porast1/suspension-telemetry/PCB_Design/Suspension_telemetry/lib_symbol/3dmodel/OLED-128x64-0.96.png

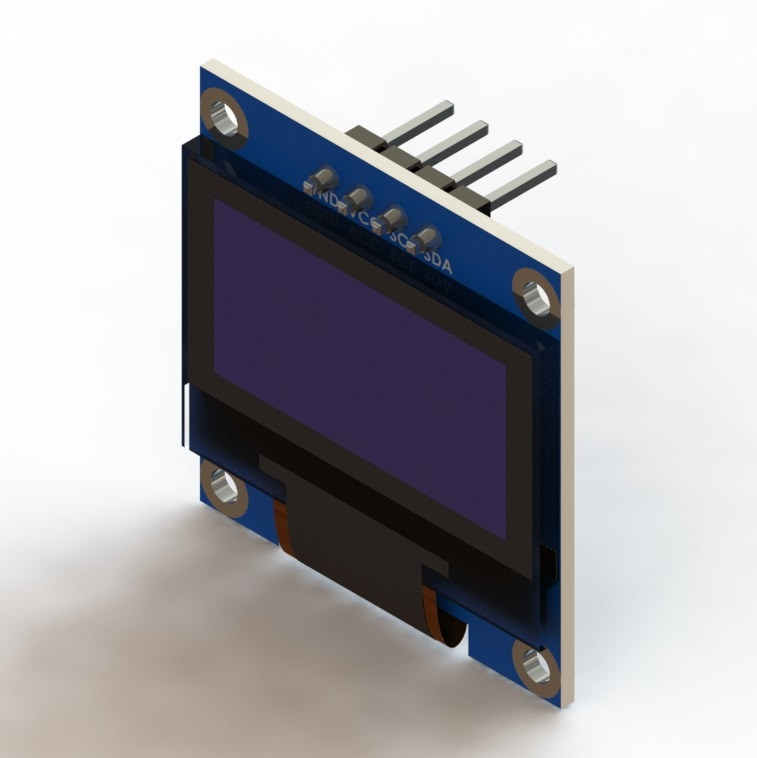
PCB_Design/Suspension_telemetry/lib_symbol/3dmodel/OLED-128x64-0.96.png
