porast1/suspension-telemetry/Enclosure/My_Designs/Enclosure-Main_body.step

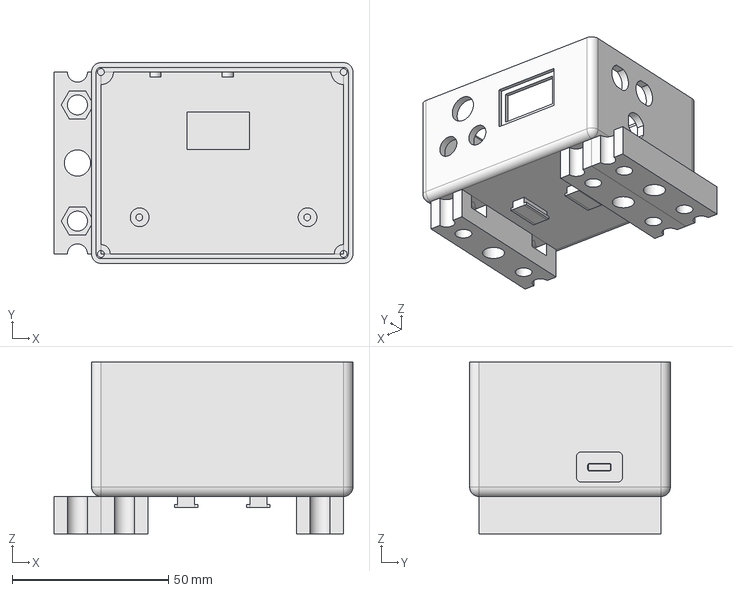
[picture p14: CAD file, 2024-03-28]
Enclosure/My_Designs/Enclosure-Main_body.step
95.6 x 64.2 x 55.0 mm
