porast1/suspension-telemetry/Enclosure/Imported/Enve M9 Carbon hanlebar DH.step

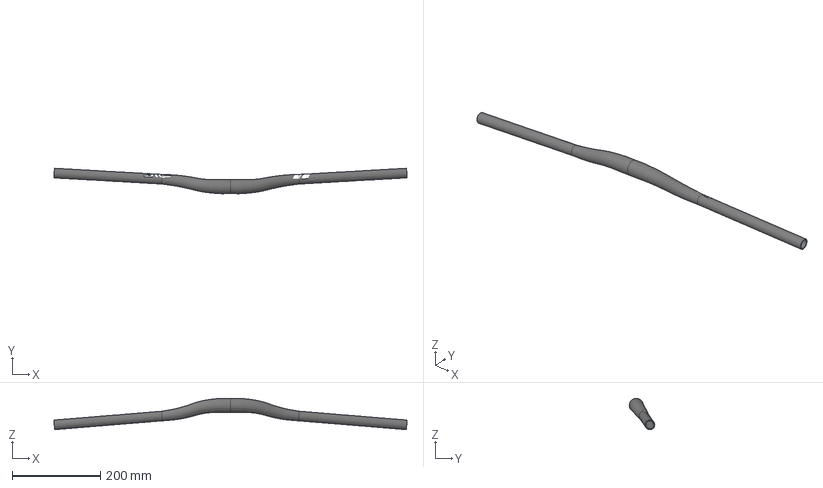
[picture p15: CAD file, 2023-11-22]
Enclosure/Imported/Enve M9 Carbon hanlebar DH.step
801.6 x 58.0 x 71.1 mm
