porast1/suspension-telemetry/Enclosure/My_Designs/mount_rear_frame_linkage-Body.step

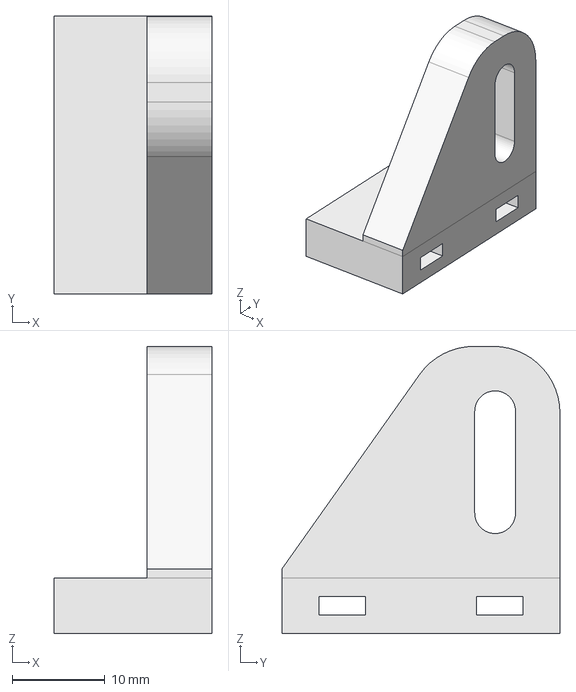
[picture p16: CAD file, 2024-03-28]
Enclosure/My_Designs/mount_rear_frame_linkage-Body.step
17.0 x 30.0 x 31.0 mm
