porast1/suspension-telemetry/PCB_Design/Suspension_telemetry/lib_symbol/3dmodel/momentary-button-switch-8mm-thread-2.snapshot.1/24V 8mm Momentary Switch.step

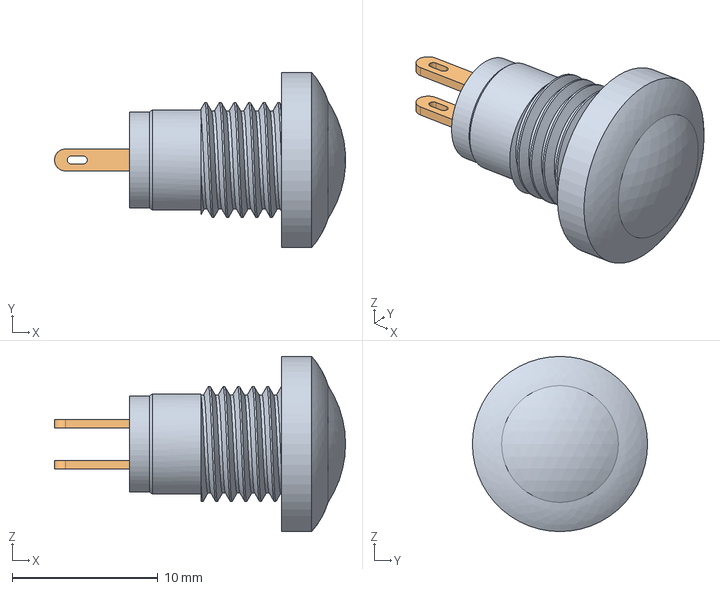
[picture p17: CAD file, 2023-11-22]
PCB_Design/Suspension_telemetry/lib_symbol/3dmodel/momentary-button-switch-8mm-thread-2.snapshot.1/24V 8mm Momentary Switch.step
19.9 x 12.0 x 12.0 mm
