porast1/suspension-telemetry/PCB_Design/Suspension_telemetry/lib_symbol/3dmodel/obudowa v3.3mf

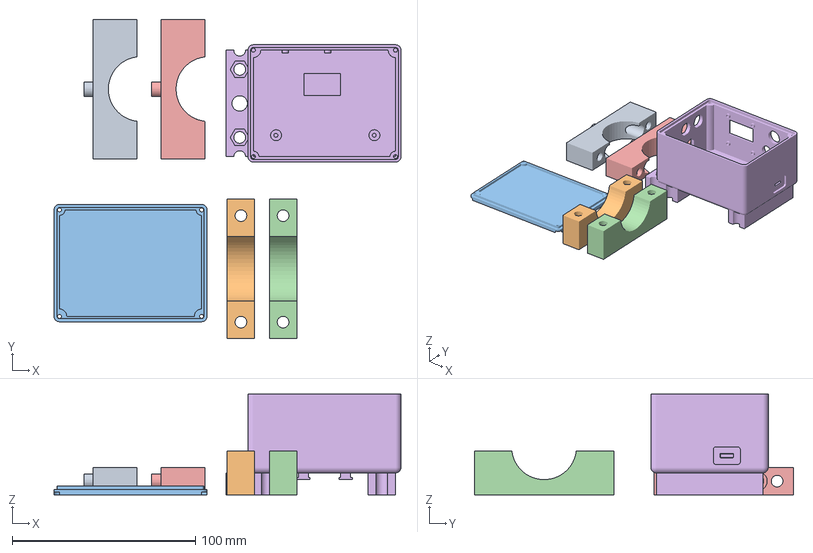
[picture p18: CAD file, 2023-12-28]
PCB_Design/Suspension_telemetry/lib_symbol/3dmodel/obudowa v3.3mf
189.6 x 174.4 x 55.0 mm
Mocowanie_obudowa_v2.stl x 2
ostatinie_mocowanie_v2.stl x 2
Pokrywa_v2.stl
obudowa v3.stl
