porast1/suspension-telemetry/PCB_Design/Suspension_telemetry/lib_symbol/LIB_112J-TDAR-R01/112J-TDAR-R01/3D/112J-TDAR-R01.stp

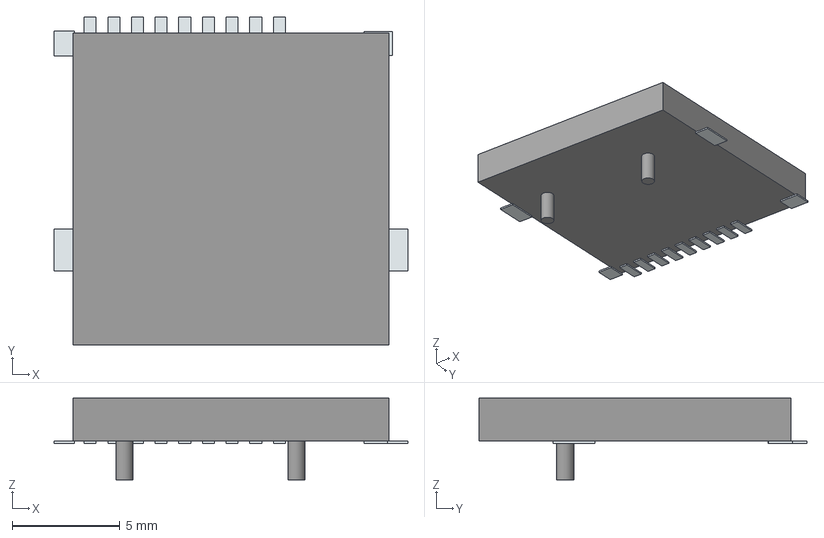
[picture p19: CAD file, 2023-10-05]
PCB_Design/Suspension_telemetry/lib_symbol/LIB_112J-TDAR-R01/112J-TDAR-R01/3D/112J-TDAR-R01.stp
16.5 x 15.2 x 3.80 mm
Pins
Lugs
