porast1/suspension-telemetry/PCB_Design/Suspension_telemetry/lib_symbol/LQH3NPZ100MJRL/3D/LQH3NPZ100MJRL.stp

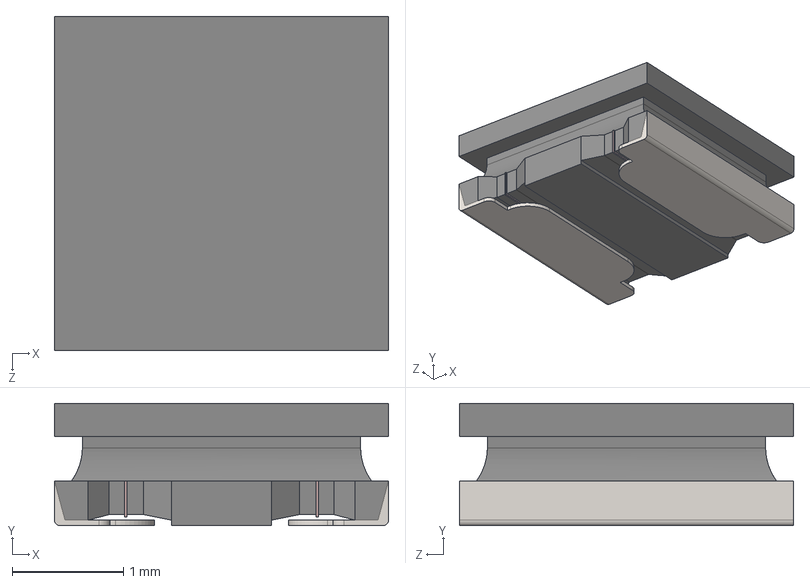
[picture p20: CAD file, 2023-11-22]
PCB_Design/Suspension_telemetry/lib_symbol/LQH3NPZ100MJRL/3D/LQH3NPZ100MJRL.stp
3.00 x 1.10 x 3.00 mm
