porast1/suspension-telemetry/PCB_Design/Suspension_telemetry/lib_symbol/MUSBRM1C1M0/3D/MUSBRM1C1M0.stp

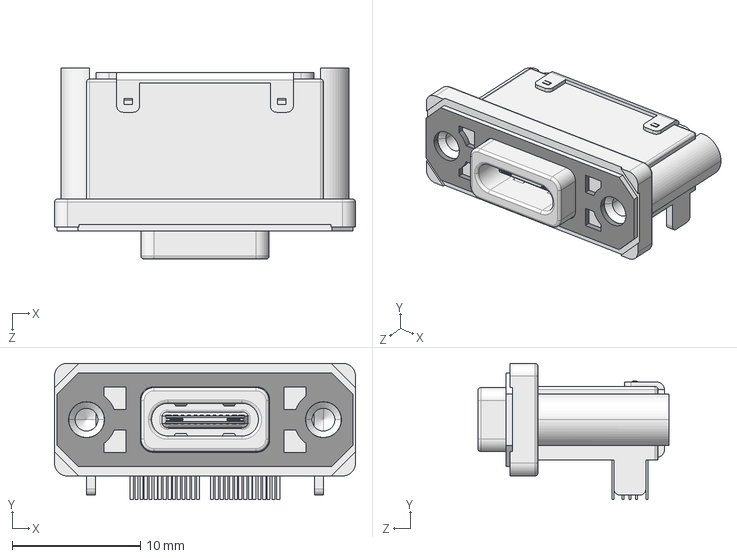
[picture p21: CAD file, 2023-11-22]
PCB_Design/Suspension_telemetry/lib_symbol/MUSBRM1C1M0/3D/MUSBRM1C1M0.stp
23.5 x 10.7 x 15.0 mm
