porast1/suspension-telemetry/PCB_Design/Suspension_telemetry/lib_symbol/zips/LIB_ABS07-32.768KHZ-9-T/ABS07-32.768KHZ-9-T/3D/ABS07-32.768KHZ-9-T.stp

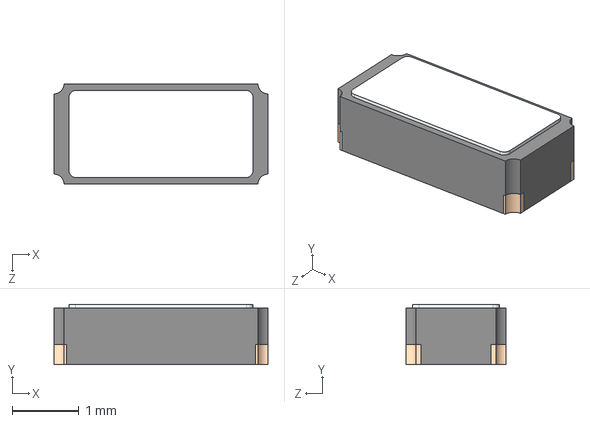
[picture p22: CAD file, 2023-10-05]
PCB_Design/Suspension_telemetry/lib_symbol/zips/LIB_ABS07-32.768KHZ-9-T/ABS07-32.768KHZ-9-T/3D/ABS07-32.768KHZ-9-T.stp
3.20 x 0.9 x 1.50 mm
