porast1/suspension-telemetry/PCB_Design/Suspension_telemetry/lib_symbol/zips/LIB_DR73-6R8-R/DR73-6R8-R/3D/DR73-6R8-R.stp

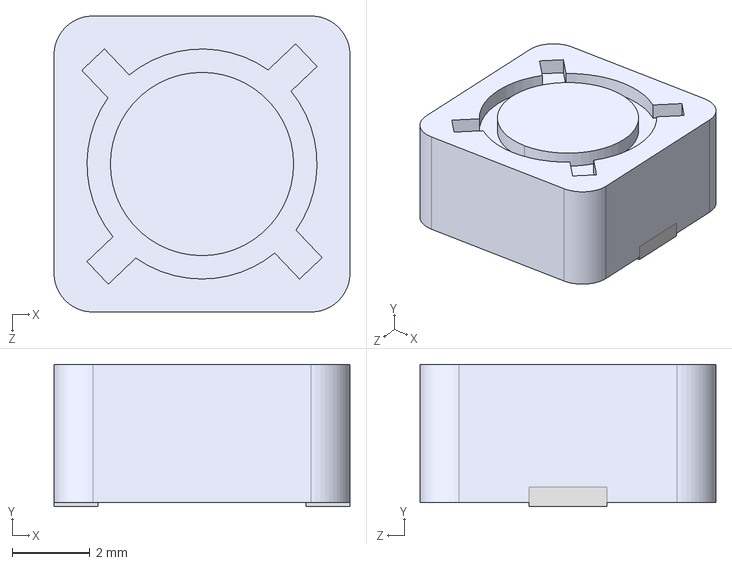
[picture p23: CAD file, 2023-10-05]
PCB_Design/Suspension_telemetry/lib_symbol/zips/LIB_DR73-6R8-R/DR73-6R8-R/3D/DR73-6R8-R.stp
7.60 x 3.65 x 7.60 mm
