porast1/suspension-telemetry/PCB_Design/Suspension_telemetry/lib_symbol/zips/LIB_HBHR-B2-10-VG-SMT/HBHR-B2-10-VG-SMT/3D/HBHR-B2-10-VG-SMT.stp

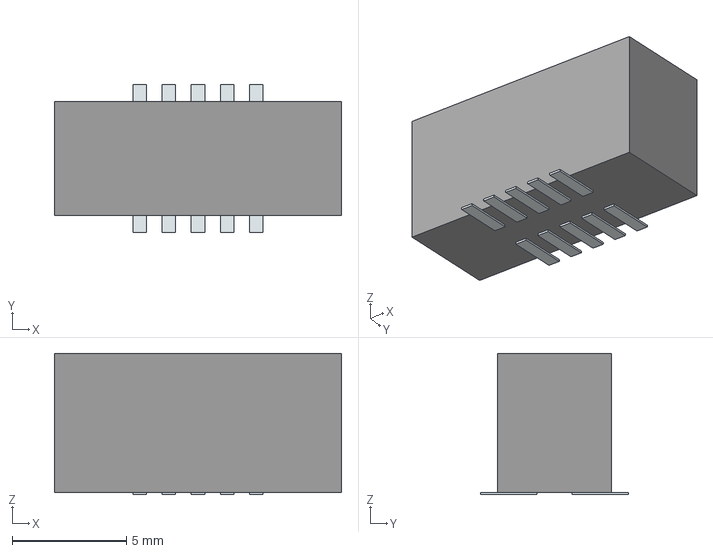
[picture p24: CAD file, 2023-10-05]
PCB_Design/Suspension_telemetry/lib_symbol/zips/LIB_HBHR-B2-10-VG-SMT/HBHR-B2-10-VG-SMT/3D/HBHR-B2-10-VG-SMT.stp
12.6 x 6.45 x 6.18 mm
Pins
