porast1/suspension-telemetry/PCB_Design/Suspension_telemetry/lib_symbol/zips/LIB_SI4435DY/SI4435DY/3D/SI4435DY.stp

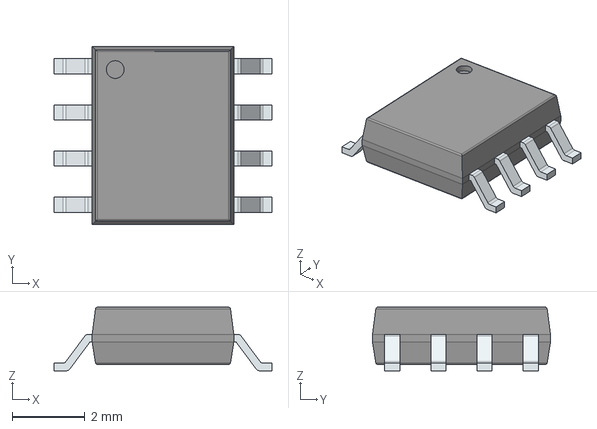
[picture p25: CAD file, 2023-10-05]
PCB_Design/Suspension_telemetry/lib_symbol/zips/LIB_SI4435DY/SI4435DY/3D/SI4435DY.stp
6.00 x 4.90 x 1.75 mm
PinsArrayLR
