porast1/suspension-telemetry/PCB_Design/Suspension_telemetry/lib_symbol/zips/LIB_USB4500-03-0-A/USB4500-03-0-A/3D/USB4500-03-0-A.stp

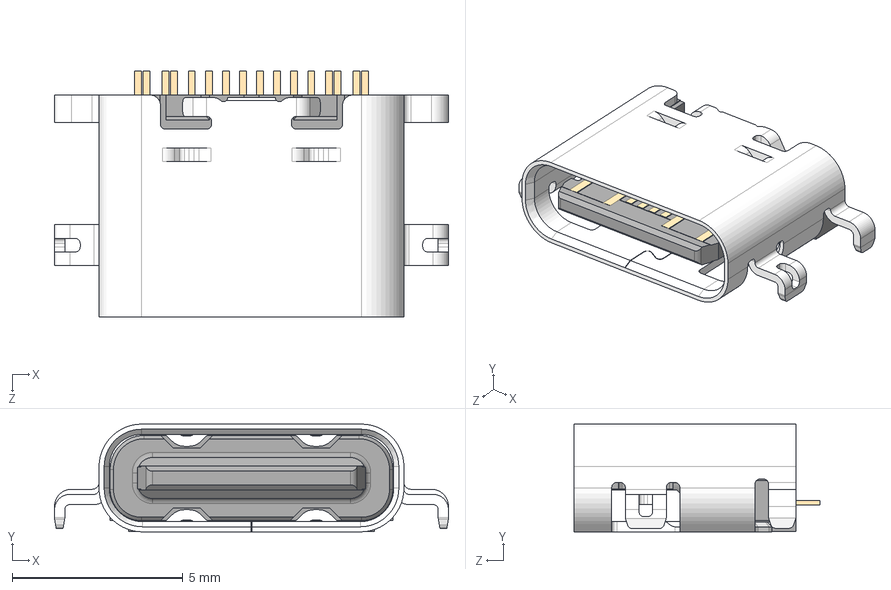
[picture p26: CAD file, 2023-10-05]
PCB_Design/Suspension_telemetry/lib_symbol/zips/LIB_USB4500-03-0-A/USB4500-03-0-A/3D/USB4500-03-0-A.stp
11.6 x 3.16 x 7.20 mm
housing mid 0.80
shell without spring
