porast1/suspension-telemetry/PCB_Design/Suspension_telemetry/travel_pressure_pcb/travel_pressure_pcb.step

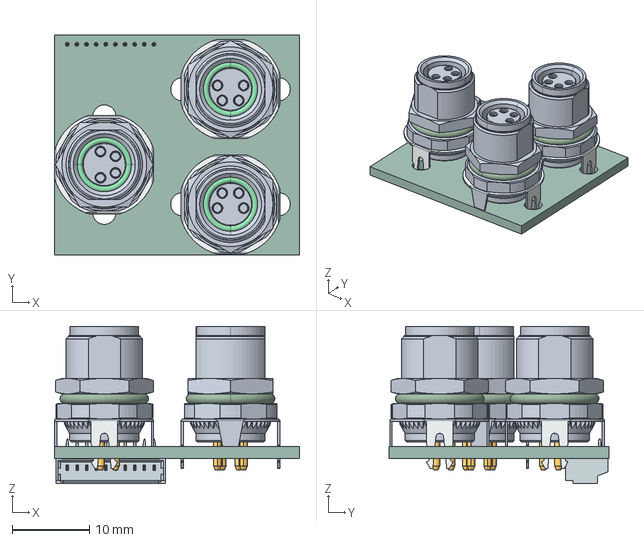
[picture p27: CAD file, 2023-11-22]
PCB_Design/Suspension_telemetry/travel_pressure_pcb/travel_pressure_pcb.step
31.8 x 28.6 x 20.4 mm
travel_pressure_pcb PCB
