porast1/suspension-telemetry/Enclosure/My_Designs/mount_bottom_fork.step

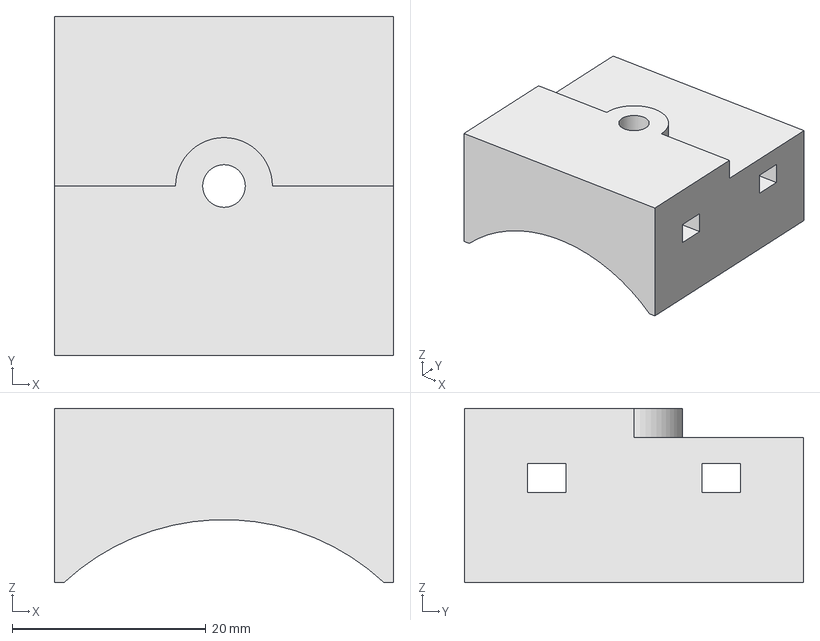
[picture p28: CAD file, 2024-03-28]
Enclosure/My_Designs/mount_bottom_fork.step
35.0 x 35.0 x 18.0 mm
