porast1/suspension-telemetry/Enclosure/My_Designs/Battery_mount.step

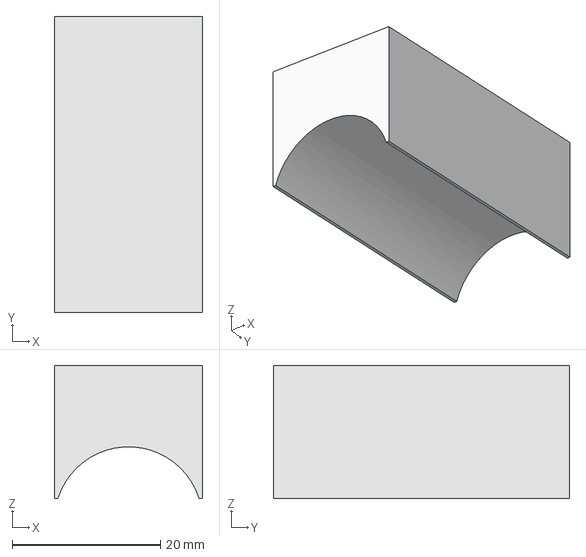
[picture p29: CAD file, 2024-03-28]
Enclosure/My_Designs/Battery_mount.step
20.0 x 40.0 x 18.0 mm
