porast1/suspension-telemetry/PCB_Design/Suspension_telemetry/lib_symbol/3dmodel/Monochrome 0.91’’ 128x32 I2C OLED Display DFR0647 (DFROBOT).STEP

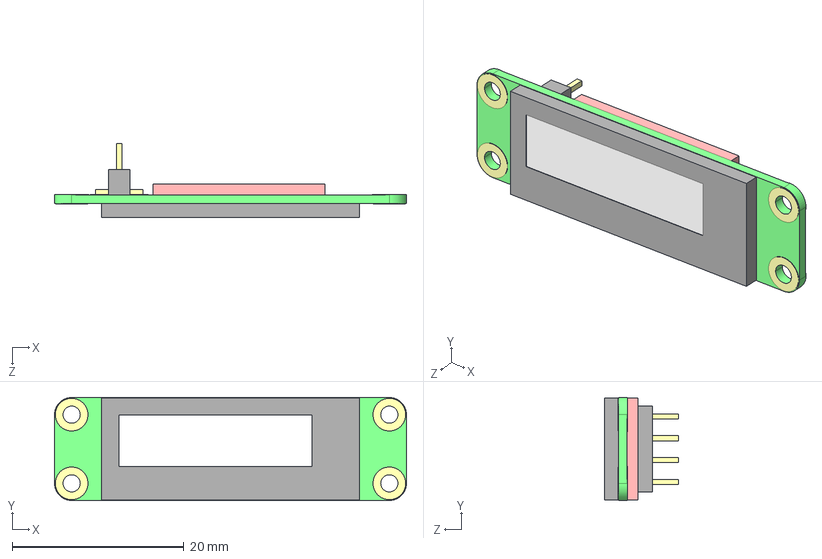
[picture p30: CAD file, 2023-11-22]
PCB_Design/Suspension_telemetry/lib_symbol/3dmodel/Monochrome 0.91’’ 128x32 I2C OLED Display DFR0647 (DFROBOT).STEP
41.0 x 12.0 x 8.60 mm
