porast1/suspension-telemetry/Enclosure/My_Designs/Enclosure-Handlebar_Mount_2.step

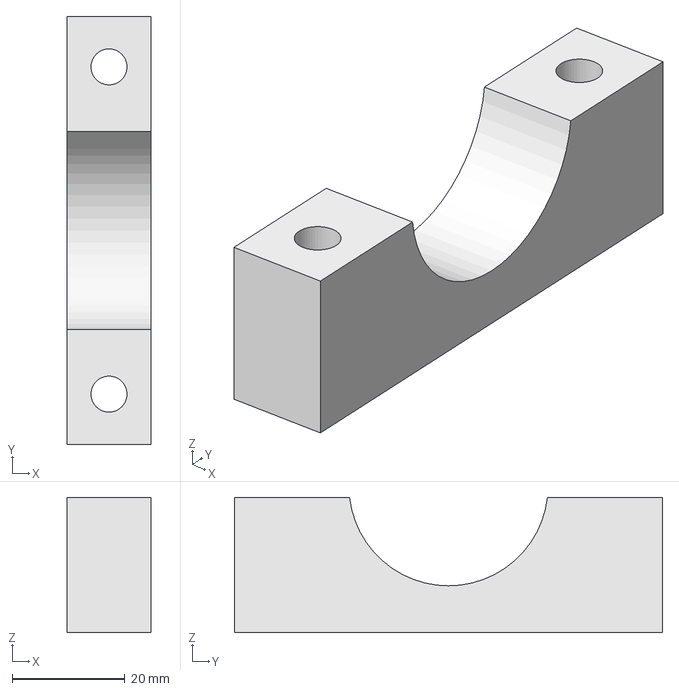
[picture p31: CAD file, 2024-03-28]
Enclosure/My_Designs/Enclosure-Handlebar_Mount_2.step
15.0 x 76.2 x 24.0 mm
