porast1/suspension-telemetry/PCB_Design/Suspension_telemetry/lib_symbol/3dmodel/USB3505-30-A--3DModel-STEP-56544.STEP

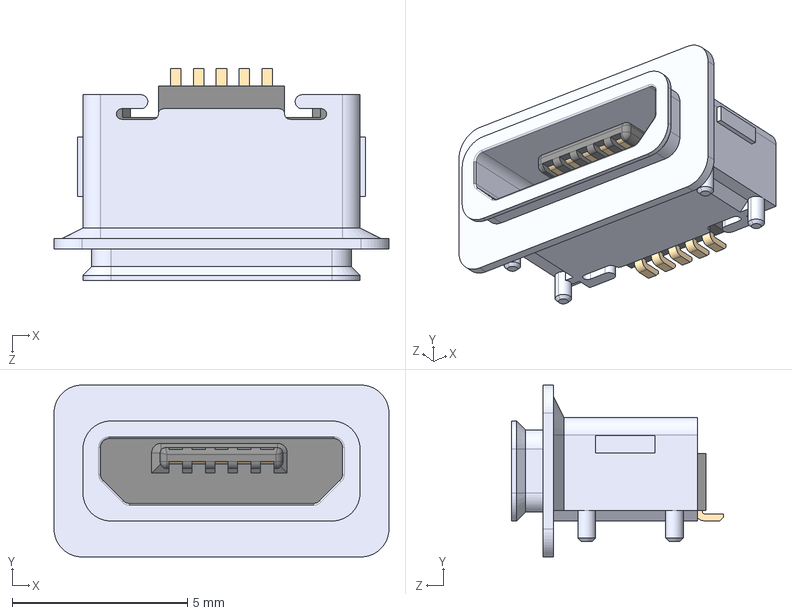
[picture p32: CAD file, 2023-11-22]
PCB_Design/Suspension_telemetry/lib_symbol/3dmodel/USB3505-30-A--3DModel-STEP-56544.STEP
9.55 x 4.90 x 6.05 mm
