porast1/suspension-telemetry/PCB_Design/Suspension_telemetry/lib_symbol/3dmodel/OLED-128x64-0.96.step

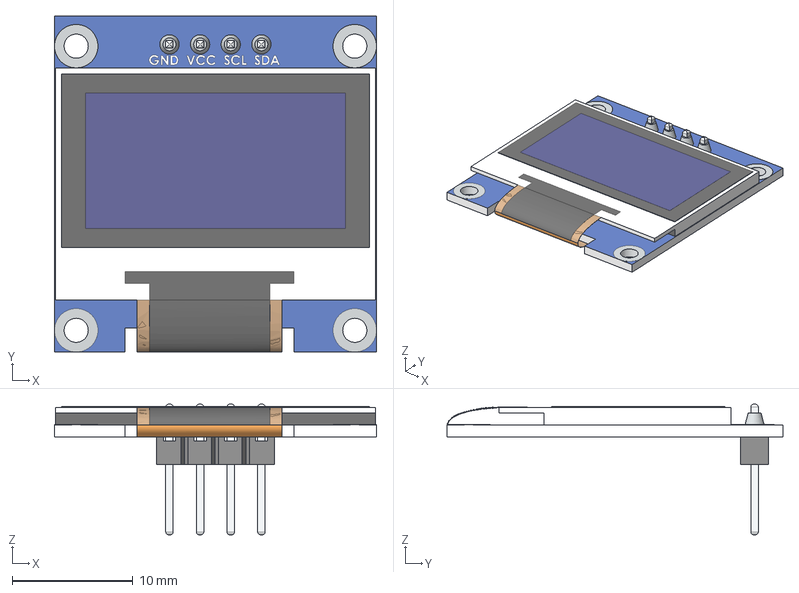
[picture p33: CAD file, 2023-11-22]
PCB_Design/Suspension_telemetry/lib_symbol/3dmodel/OLED-128x64-0.96.step
26.7 x 27.9 x 10.8 mm
