porast1/suspension-telemetry/Enclosure/My_Designs/Enclosure-Handlebar_Mount_1.step

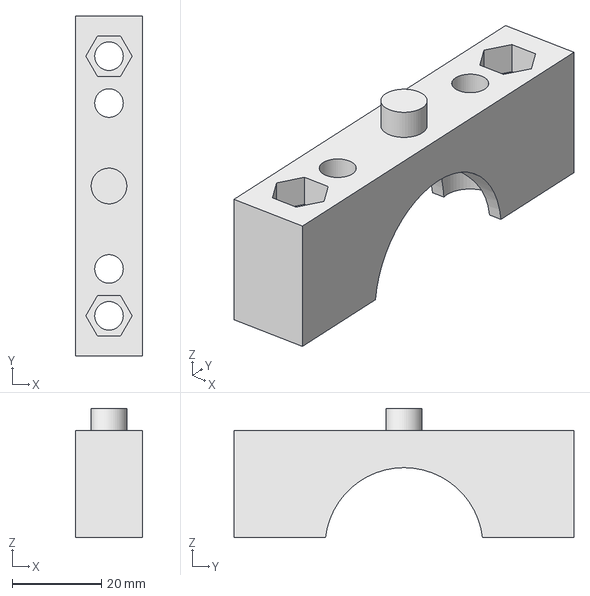
[picture p34: CAD file, 2024-03-28]
Enclosure/My_Designs/Enclosure-Handlebar_Mount_1.step
15.0 x 76.2 x 29.0 mm
