porast1/suspension-telemetry/Enclosure/My_Designs/Enclosure-Cover.step

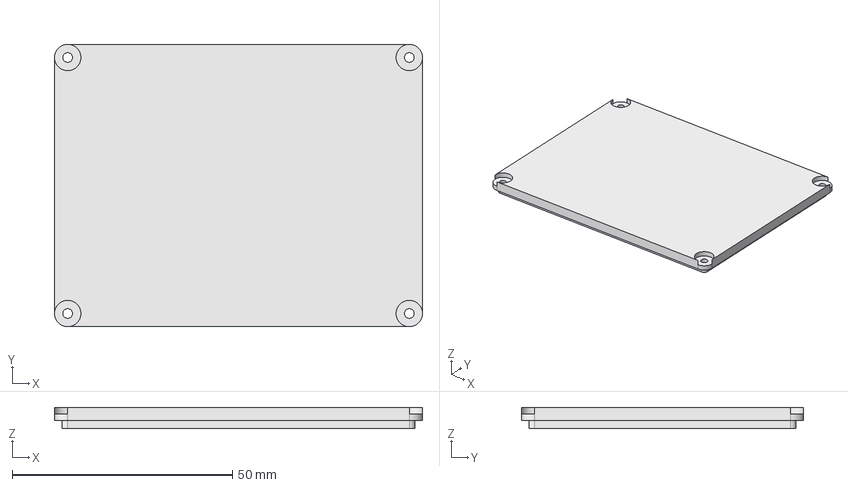
[picture p35: CAD file, 2024-03-28]
Enclosure/My_Designs/Enclosure-Cover.step
83.6 x 64.2 x 4.80 mm
