porast1/suspension-telemetry/PCB_Design/Suspension_telemetry/lib_symbol/3dmodel/125SH-A-04-TS.stp

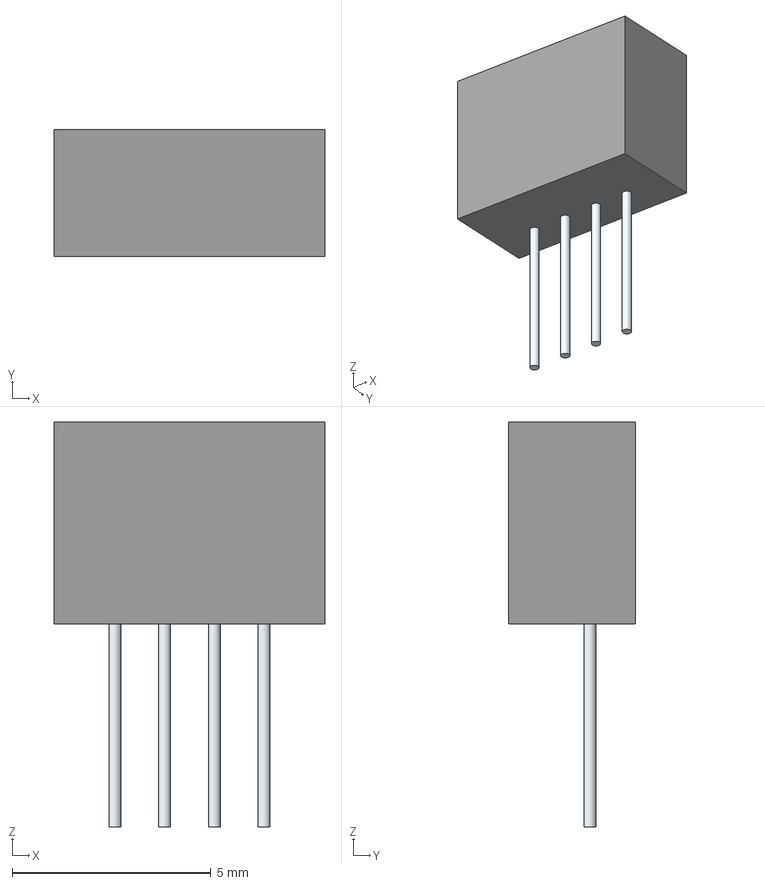
[picture p36: CAD file, 2023-11-22]
PCB_Design/Suspension_telemetry/lib_symbol/3dmodel/125SH-A-04-TS.stp
6.80 x 3.20 x 10.2 mm
Leads
