porast1/suspension-telemetry/PCB_Design/Suspension_telemetry/lib_symbol/3dmodel/M10 Push Button.step

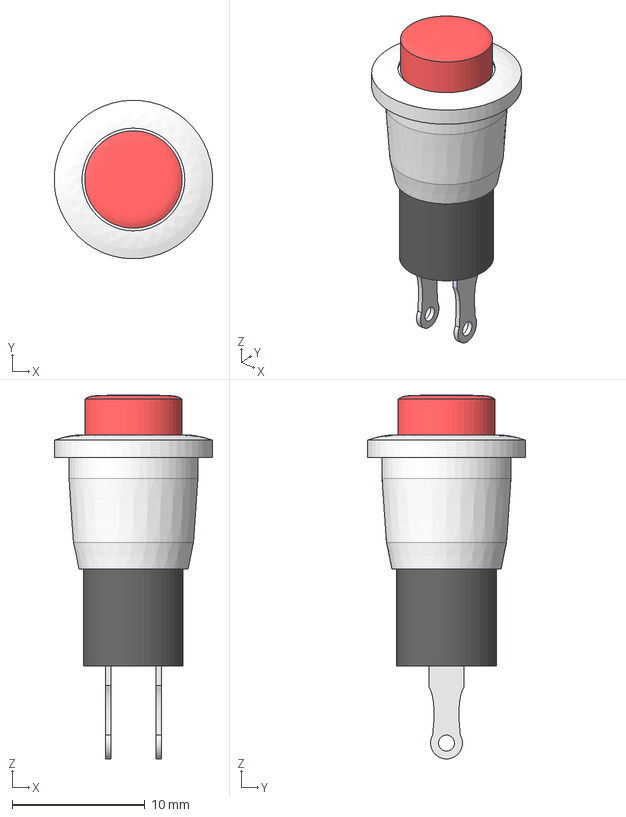
[picture p37: CAD file, 2023-11-22]
PCB_Design/Suspension_telemetry/lib_symbol/3dmodel/M10 Push Button.step
11.9 x 11.9 x 27.4 mm
Metal_Body
Plastic_Body
Contact1
Button
Contact2
