porast1/suspension-telemetry/PCB_Design/Suspension_telemetry/lib_symbol/3dmodel/BK-18650-PC2.step

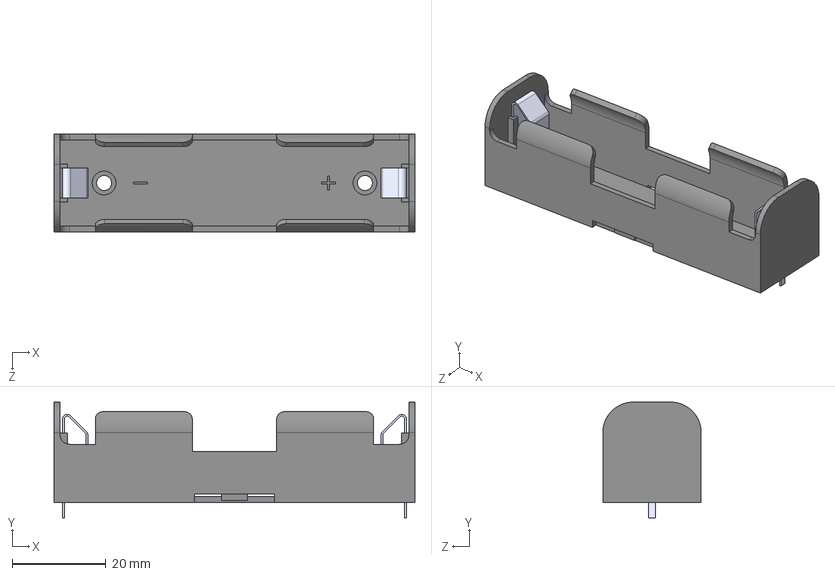
[picture p38: CAD file, 2023-10-05]
PCB_Design/Suspension_telemetry/lib_symbol/3dmodel/BK-18650-PC2.step
77.0 x 24.7 x 21.0 mm
