porast1/suspension-telemetry/(list of files, cad)

Other CAD files:
PCB_Design/Suspension_telemetry/lib_symbol/3dmodel/MUSBRM1C130.stp
PCB_Design/Suspension_telemetry/lib_symbol/125SH-A-04-TS/Allegro/125sha04ts.psm
PCB_Design/Suspension_telemetry/lib_symbol/125SH-A-04-TS/DEHDL/125sh_a_04_ts/chips/chips.prt
PCB_Design/Suspension_telemetry/lib_symbol/22057025/3D/22057025.stp
PCB_Design/Suspension_telemetry/lib_symbol/22057025/Allegro/22057025.psm
PCB_Design/Suspension_telemetry/lib_symbol/22057025/DEHDL/22057025/chips/chips.prt
PCB_Design/Suspension_telemetry/lib_symbol/3dmodel/12010973.stp
PCB_Design/Suspension_telemetry/lib_symbol/3dmodel/530481010.stp
PCB_Design/Suspension_telemetry/lib_symbol/LIB_112J-TDAR-R01/112J-TDAR-R01/Allegro/112jtdarr01.psm
PCB_Design/Suspension_telemetry/lib_symbol/LIB_112J-TDAR-R01/112J-TDAR-R01/DEHDL/112j_tdar_r01/chips/chips.prt
PCB_Design/Suspension_telemetry/lib_symbol/LIB_22057025/22057025/3D/22057025.stp
PCB_Design/Suspension_telemetry/lib_symbol/LIB_22057025/22057025/Allegro/22057025.psm
PCB_Design/Suspension_telemetry/lib_symbol/LIB_22057025/22057025/DEHDL/22057025/chips/chips.prt
PCB_Design/Suspension_telemetry/lib_symbol/LIB_280384-1/280384-1/3D/280384-1.stp
PCB_Design/Suspension_telemetry/lib_symbol/LIB_280384-1/280384-1/Allegro/2803841.psm
PCB_Design/Suspension_telemetry/lib_symbol/LIB_280384-1/280384-1/DEHDL/280384_1/chips/chips.prt
PCB_Design/Suspension_telemetry/lib_symbol/LIB_530481010/530481010/Allegro/530481010.psm
PCB_Design/Suspension_telemetry/lib_symbol/LIB_530481010/530481010/DEHDL/530481010/chips/chips.prt
PCB_Design/Suspension_telemetry/lib_symbol/LIB_OS102011MA1QN1/OS102011MA1QN1/3D/OS102011MA1QN1.stp
PCB_Design/Suspension_telemetry/lib_symbol/LIB_OS102011MA1QN1/OS102011MA1QN1/Allegro/os102011ma1qn1.psm
PCB_Design/Suspension_telemetry/lib_symbol/LIB_OS102011MA1QN1/OS102011MA1QN1/DEHDL/os102011ma1qn1/chips/chips.prt
PCB_Design/Suspension_telemetry/lib_symbol/LQH3NPZ100MJRL/Allegro/lqh3npn100mjrl.psm
PCB_Design/Suspension_telemetry/lib_symbol/LQH3NPZ100MJRL/DEHDL/lqh3npz100mjrl/chips/chips.prt
PCB_Design/Suspension_telemetry/lib_symbol/MCP73114-0NSI_MF/3D/MCP73114-0NSI_MF.stp
PCB_Design/Suspension_telemetry/lib_symbol/MCP73114-0NSI_MF/Allegro/son50p300x300x100-11n-d.psm
PCB_Design/Suspension_telemetry/lib_symbol/MCP73114-0NSI_MF/DEHDL/mcp73114_0nsi_mf/chips/chips.prt
PCB_Design/Suspension_telemetry/lib_symbol/MUSBRM1C130/Allegro/musbrm1c130.psm
PCB_Design/Suspension_telemetry/lib_symbol/MUSBRM1C130/DEHDL/musbrm1c130/chips/chips.prt
PCB_Design/Suspension_telemetry/lib_symbol/MUSBRM1C1M0/Allegro/musbrm1c1m0.psm
PCB_Design/Suspension_telemetry/lib_symbol/MUSBRM1C1M0/DEHDL/musbrm1c1m0/chips/chips.prt
PCB_Design/Suspension_telemetry/lib_symbol/OS102011MS2QN1C/3D/OS102011MS2QN1C.stp
PCB_Design/Suspension_telemetry/lib_symbol/OS102011MS2QN1C/Allegro/os102011ms2qn1c.psm
PCB_Design/Suspension_telemetry/lib_symbol/OS102011MS2QN1C/DEHDL/os102011ms2qn1c/chips/chips.prt
PCB_Design/Suspension_telemetry/lib_symbol/TLV61046ADBVR/3D/TLV61046ADBVR.stp
PCB_Design/Suspension_telemetry/lib_symbol/TLV61046ADBVR/Allegro/sot95p280x145-6n.psm
PCB_Design/Suspension_telemetry/lib_symbol/TLV61046ADBVR/DEHDL/tlv61046adbvr/chips/chips.prt
PCB_Design/Suspension_telemetry/lib_symbol/zips/LIB_1825965-1/1825965-1/3D/1825965-1.stp
PCB_Design/Suspension_telemetry/lib_symbol/zips/LIB_1825965-1/1825965-1/Allegro/18259651.psm
PCB_Design/Suspension_telemetry/lib_symbol/zips/LIB_1825965-1/1825965-1/DEHDL/1825965_1/chips/chips.prt
PCB_Design/Suspension_telemetry/lib_symbol/zips/LIB_530480310/530480310/3D/530480310.stp
PCB_Design/Suspension_telemetry/lib_symbol/zips/LIB_530480310/530480310/Allegro/530480310.psm
PCB_Design/Suspension_telemetry/lib_symbol/zips/LIB_530480310/530480310/DEHDL/530480310/chips/chips.prt
PCB_Design/Suspension_telemetry/lib_symbol/zips/LIB_530480410/530480410/3D/530480410.stp
PCB_Design/Suspension_telemetry/lib_symbol/zips/LIB_530480410/530480410/Allegro/530480410.psm
PCB_Design/Suspension_telemetry/lib_symbol/zips/LIB_530480410/530480410/DEHDL/530480410/chips/chips.prt
PCB_Design/Suspension_telemetry/lib_symbol/zips/LIB_530480510/530480510/3D/530480510.stp
PCB_Design/Suspension_telemetry/lib_symbol/zips/LIB_530480510/530480510/Allegro/530480510.psm
PCB_Design/Suspension_telemetry/lib_symbol/zips/LIB_530480510/530480510/DEHDL/530480510/chips/chips.prt
PCB_Design/Suspension_telemetry/lib_symbol/zips/LIB_ABS07-32.768KHZ-9-T/ABS07-32.768KHZ-9-T/Allegro/abs07.psm
PCB_Design/Suspension_telemetry/lib_symbol/zips/LIB_ABS07-32.768KHZ-9-T/ABS07-32.768KHZ-9-T/DEHDL/abs07_32.768khz_9_t/chips/chips.prt
PCB_Design/Suspension_telemetry/lib_symbol/zips/LIB_DR73-6R8-R/DR73-6R8-R/Allegro/indm7676x355n.psm
PCB_Design/Suspension_telemetry/lib_symbol/zips/LIB_DR73-6R8-R/DR73-6R8-R/DEHDL/dr73_6r8_r/chips/chips.prt
PCB_Design/Suspension_telemetry/lib_symbol/zips/LIB_HBHR-B2-10-VG-SMT/HBHR-B2-10-VG-SMT/Allegro/hbhrb210vgsmt.psm
PCB_Design/Suspension_telemetry/lib_symbol/zips/LIB_HBHR-B2-10-VG-SMT/HBHR-B2-10-VG-SMT/DEHDL/hbhr_b2_10_vg_smt/chips/chips.prt
PCB_Design/Suspension_telemetry/lib_symbol/zips/LIB_MCP73844-840I_MS/MCP73844-840I_MS/3D/MCP73844-840I_MS.stp
PCB_Design/Suspension_telemetry/lib_symbol/zips/LIB_MCP73844-840I_MS/MCP73844-840I_MS/Allegro/sop65p490x110-8n.psm
PCB_Design/Suspension_telemetry/lib_symbol/zips/LIB_MCP73844-840I_MS/MCP73844-840I_MS/DEHDL/mcp73844_840i_ms/chips/chips.prt
PCB_Design/Suspension_telemetry/lib_symbol/zips/LIB_SI4435DY/SI4435DY/Allegro/soic127p600x175-8n.psm
PCB_Design/Suspension_telemetry/lib_symbol/zips/LIB_SI4435DY/SI4435DY/DEHDL/si4435dy/chips/chips.prt
PCB_Design/Suspension_telemetry/lib_symbol/zips/LIB_USB4500-03-0-A/USB4500-03-0-A/Allegro/usb4500030a.psm
PCB_Design/Suspension_telemetry/lib_symbol/zips/LIB_USB4500-03-0-A/USB4500-03-0-A/DEHDL/usb4500_03_0_a/chips/chips.prt
