porast1/suspension-telemetry/(list of files, drawings)

Other design files:
PCB_Design/Suspension_telemetry/FREEROUTIN_DSN/Suspension_telemetry.dsn
PCB_Design/Suspension_telemetry/freerouting.dsn
PCB_Design/Suspension_telemetry/lib_symbol/125SH-A-04-TS/Altium/125SH-A-04-TS.SchLib
PCB_Design/Suspension_telemetry/lib_symbol/125SH-A-04-TS/Altium/125SHA04TS.PcbLib
PCB_Design/Suspension_telemetry/lib_symbol/LIB_112J-TDAR-R01/112J-TDAR-R01/Altium/112J-TDAR-R01.SchLib
PCB_Design/Suspension_telemetry/lib_symbol/LIB_112J-TDAR-R01/112J-TDAR-R01/Altium/112JTDARR01.PcbLib
PCB_Design/Suspension_telemetry/lib_symbol/LIB_280384-1/280384-1/Altium/280384-1.SchLib
PCB_Design/Suspension_telemetry/lib_symbol/LIB_280384-1/280384-1/Altium/2803841.PcbLib
PCB_Design/Suspension_telemetry/lib_symbol/LQH3NPZ100MJRL/Altium/LQH3NPN100MJRL.PcbLib
PCB_Design/Suspension_telemetry/lib_symbol/LQH3NPZ100MJRL/Altium/LQH3NPZ100MJRL.SchLib
PCB_Design/Suspension_telemetry/lib_symbol/MCP73114-0NSI_MF/Altium/MCP73114-0NSI_MF.SchLib
PCB_Design/Suspension_telemetry/lib_symbol/MCP73114-0NSI_MF/Altium/SON50P300X300X100-11N-D.PcbLib
PCB_Design/Suspension_telemetry/lib_symbol/MUSBRM1C1M0/Altium/MUSBRM1C1M0.PcbLib
PCB_Design/Suspension_telemetry/lib_symbol/MUSBRM1C1M0/Altium/MUSBRM1C1M0.SchLib
PCB_Design/Suspension_telemetry/lib_symbol/OS102011MS2QN1C/Altium/OS102011MS2QN1C.PcbLib
PCB_Design/Suspension_telemetry/lib_symbol/OS102011MS2QN1C/Altium/OS102011MS2QN1C.SchLib
PCB_Design/Suspension_telemetry/lib_symbol/TLV61046ADBVR/Altium/SOT95P280X145-6N.PcbLib
PCB_Design/Suspension_telemetry/lib_symbol/TLV61046ADBVR/Altium/TLV61046ADBVR.SchLib
PCB_Design/Suspension_telemetry/lib_symbol/zips/LIB_112J-TDAR-R01/112J-TDAR-R01/Altium/112J-TDAR-R01.SchLib
PCB_Design/Suspension_telemetry/lib_symbol/zips/LIB_112J-TDAR-R01/112J-TDAR-R01/Altium/112JTDARR01.PcbLib
PCB_Design/Suspension_telemetry/lib_symbol/zips/LIB_1825965-1/1825965-1/Altium/1825965-1.SchLib
PCB_Design/Suspension_telemetry/lib_symbol/zips/LIB_1825965-1/1825965-1/Altium/18259651.PcbLib
PCB_Design/Suspension_telemetry/lib_symbol/zips/LIB_HBHR-B2-10-VG-SMT/HBHR-B2-10-VG-SMT/Altium/HBHR-B2-10-VG-SMT.SchLib
PCB_Design/Suspension_telemetry/lib_symbol/zips/LIB_HBHR-B2-10-VG-SMT/HBHR-B2-10-VG-SMT/Altium/HBHRB210VGSMT.PcbLib
PCB_Design/Suspension_telemetry/lib_symbol/zips/LIB_MCP73844-840I_MS/MCP73844-840I_MS/Altium/MCP73844-840I_MS.SchLib
PCB_Design/Suspension_telemetry/lib_symbol/zips/LIB_MCP73844-840I_MS/MCP73844-840I_MS/Altium/SOP65P490X110-8N.PcbLib
PCB_Design/Suspension_telemetry/lib_symbol/zips/LIB_SI4435DY/SI4435DY/Altium/SI4435DY.SchLib
PCB_Design/Suspension_telemetry/lib_symbol/zips/LIB_SI4435DY/SI4435DY/Altium/SOIC127P600X175-8N.PcbLib
