porast1/suspension-telemetry/PCB_Design/Suspension_telemetry/Suspension_telemetry.kicad_pcb

## KiCad design PCB_Design/Suspension_telemetry/Suspension_telemetry.kicad_pcb (2024-03-28)

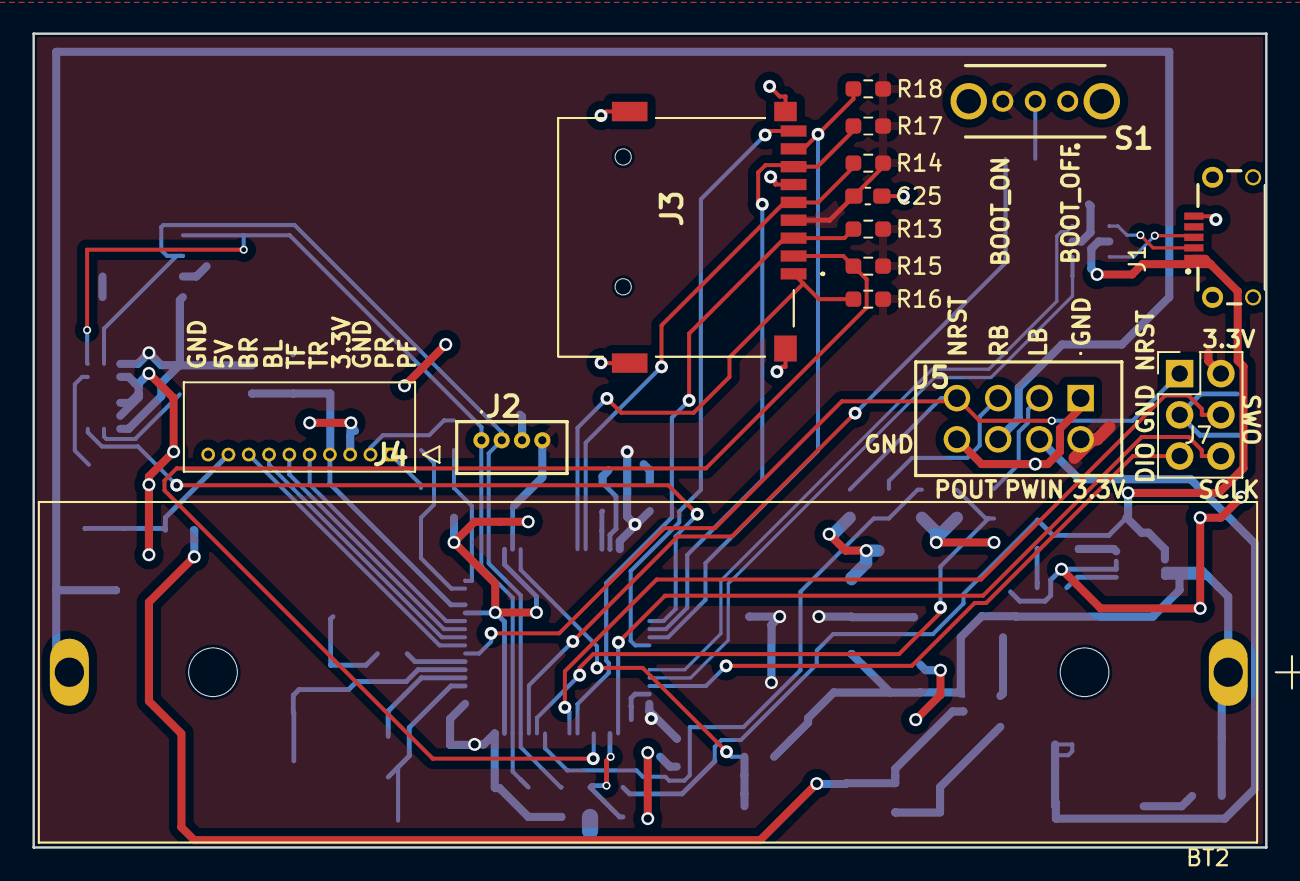
[picture p39: board Suspension_telemetry.kicad_pcb from above]

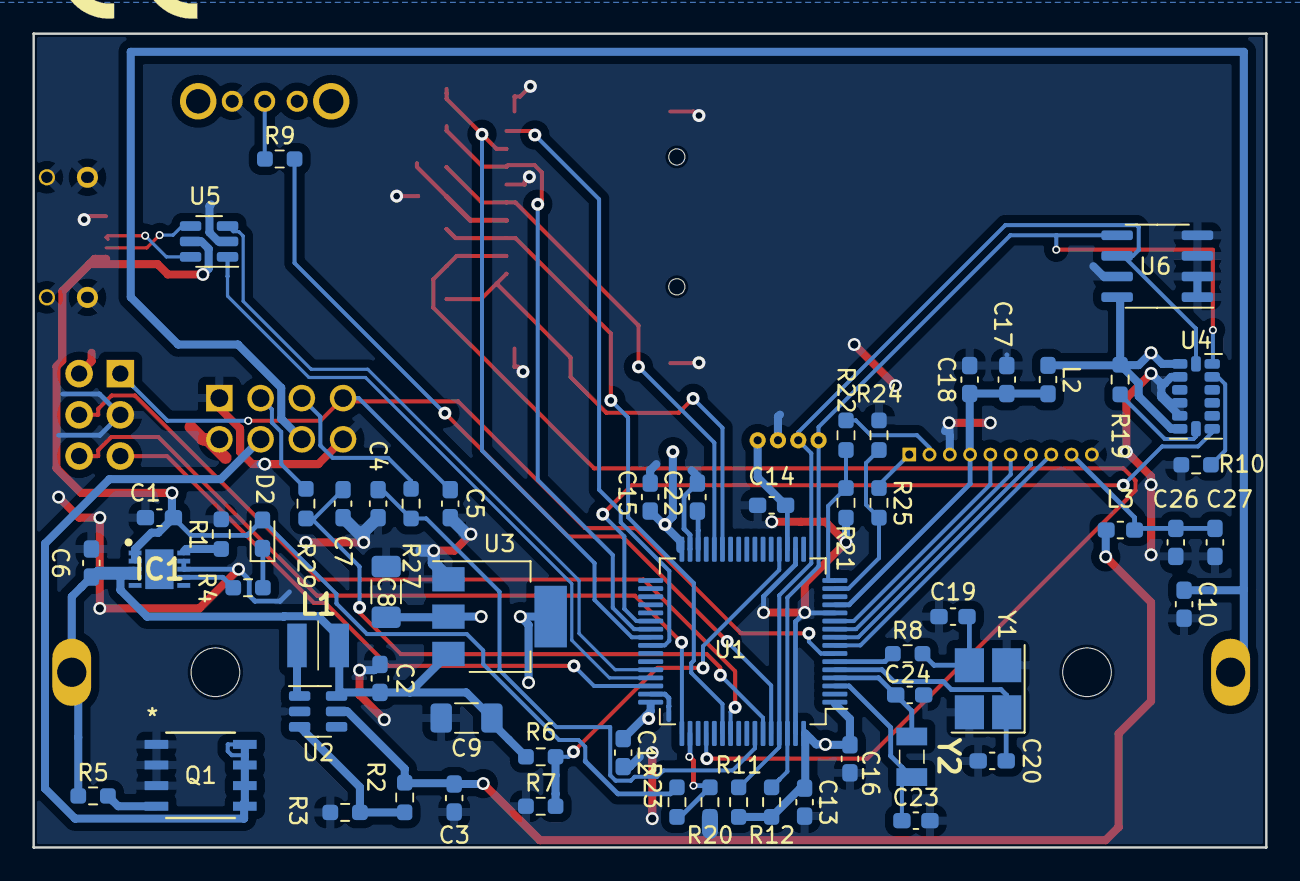
[picture p40: board Suspension_telemetry.kicad_pcb from below]

Board: 2 copper layers, 75.9 x 50.1 mm, 77 parts (62 on the bottom side), 57 nets.

Parts:
BT2: BK-18650-PC2; BAT_BK-18650-PC2
C1, C2, C3, C6, C17, C26: 1uF; C_0603_1608Metric_Pad1.08x0.95mm_HandSolder
C4, C5, C7, C10, C13, C14, C15, C16, C25: 100n; C_0603_1608Metric_Pad1.08x0.95mm_HandSolder
C8, C9: 10uF; C_1206_3216Metric_Pad1.33x1.80mm_HandSolder
C12, C22: 4,7uF; C_0603_1608Metric_Pad1.08x0.95mm_HandSolder
C18, C27: 10n; C_0603_1608Metric_Pad1.08x0.95mm_HandSolder
C19, C20, C23, C24: 8p; C_0603_1608Metric_Pad1.08x0.95mm_HandSolder
D2: LED_Small; LED_0603_1608Metric_Pad1.05x0.95mm_HandSolder
IC1: MCP73114-0NSI_MF; SON50P300X300X100-11N-D
J1: USB3505-30-A_REVA4; GCT_USB3505-30-A_REVA4
J2: 125SH-A-04-TS; 125SHA04TS
J3: 112J-TDAR-R01; 112JTDARR01
J4: 530481010
J5: 280384-1; 2803841
J7: Conn_02x03_Top_Bottom; PinHeader_2x03_P2.54mm_Vertical
L1: LQH3NPZ100MJRL; LQH3NPN100MJRL
L2, L3: 39n; L_0603_1608Metric_Pad1.05x0.95mm_HandSolder
N1, N2, N3: Housing; CE-Logo_8.5x6mm_SilkScreen
Q1: AOSP32368; SO8SOP-8L_AOS
R1: 1.1k; R_0603_1608Metric_Pad0.98x0.95mm_HandSolder
R2: 360k; R_0603_1608Metric_Pad0.98x0.95mm_HandSolder
R3: 68k; R_0603_1608Metric_Pad0.98x0.95mm_HandSolder
R4, R27, R29: 1k; R_0603_1608Metric_Pad0.98x0.95mm_HandSolder
R5, R9, R10, R13, R14, R15, R16, R17, R18: 10k; R_0603_1608Metric_Pad0.98x0.95mm_HandSolder
R6, R7: 100k; R_0603_1608Metric_Pad0.98x0.95mm_HandSolder
R8: 47; R_0603_1608Metric_Pad0.98x0.95mm_HandSolder
R11, R12: 2k2; R_0603_1608Metric_Pad0.98x0.95mm_HandSolder
R19, R22, R23, R25: 4,7k; R_0603_1608Metric_Pad0.98x0.95mm_HandSolder
R20, R21, R24: 6,8k; R_0603_1608Metric_Pad0.98x0.95mm_HandSolder
S1: OS102011MA1QN1
U1: STM32F446RET6; LQFP-64_10x10mm_P0.5mm
U2: TLV61046ADB; SOT-23-6
U3: LM1117MP-3.3; SOT-223-3_TabPin2
U4: ADXL343; LGA-14_3x5mm_P0.8mm_LayoutBorder1x6y
U5: USBLC6-2SC6; SOT-23-6
U6: AT24CS254-SSHM; SOIC-8_3.9x4.9mm_P1.27mm
Y1: Crystal_GND24_Small; Crystal_SMD_3225-4Pin_3.2x2.5mm_HandSoldering
Y2: ABS07-32.768KHZ-9-T; ABS07

Connections:
5V_USB: C1.1, D2.2 (A), IC1.1 (VDD_1), IC1.2 (VDD_2), J1.1 (VCC), R23.1, U5.5 (VBUS)
+3.3V: C8.1, C12.1, C13.1, C14.1, C15.1, C16.1, C25.1, J2.4, J3.4 (VDD), J5.2, J7.2, L2.1, R11.2, R12.2, R13.2, R14.2, R15.2, R16.2, R17.2, R18.2, R19.1, S1.3, U1.1 (VBAT), U1.19 (VDD), U1.32 (VDD), U1.48 (VDD), U1.64 (VDD), U3.2 (VO), U4.1 (Vdd_I/O), U4.6 (Vs), U6.8 (VCC)
+3.3VA: C17.1, C18.1, J4.4, L2.2, U1.13 (VDDA)
+5V: C3.2, L3.1, R2.1, U2.5 (VOUT)
+5VA: C26.1, C27.1, J4.9, L3.2
/Power_Stabilizer_3_3V/V_in_P: BT2.+, C2.2, C6.1, C9.1, IC1.3 (VBAT_1), IC1.4 (VBAT_2), L1.1, R5.1, R6.2, U2.6 (VI), U3.3 (VI)
ACCELEROMETER_INT0: U1.38 (PC7), U4.8 (INT1)
BATTERY_LEVEL: R6.1, R7.2, U1.20 (PA4)
BOOT: R9.2, U1.60 (BOOT0)
BRAKE_SENSOR_LEFT: J4.7, U1.9 (PC1)
BRAKE_SENSOR_RIGHT: J4.8, U1.8 (PC0)
CHARGE_DETECTION: R20.1, R23.2, U1.50 (PA15)
DATAN: J1.2 (D-), U5.4 (I/O2)
DATAP: J1.3 (D+), U5.6 (I/O1)
GND: C1.2, C2.1, C3.1, C4.2, C5.2, C6.2, C7.2, C8.2, C9.2, C10.2, C12.2, C13.2, C14.2, C15.2, C16.2, C17.2, C18.2, C19.2, C20.2, C22.2, C23.2, C24.2, C25.2, C26.2, C27.2, IC1.8 (VSS_1), IC1.9 (VSS_2), J1.5 (GND), J1.S1 (SHIELD), J1.S2 (SHIELD), J1.S3 (SHIELD), J1.S4 (SHIELD), J2.3, J3.6 (VSS), J3.G1 (GROUND), J3.MP1, J3.MP2, J3.MP3, J4.3, J4.10, J5.1, J5.8, J7.3, Q1.1, Q1.2, Q1.3, R1.2, R3.1, R7.1, R10.1, R20.2, R21.2, R24.2, S1.1, U1.12 (VSSA), U1.18 (VSS), U1.31 (VSS), U1.47 (VSS), U1.63 (VSS), U2.2 (GND), U3.1 (GND), U4.2 (GND), U4.4 (GND), U4.5 (GND), U5.2 (GND), U6.1 (A0), U6.2 (A1), U6.3 (A2), U6.4 (GND), U6.7 (WP), Y1.2, Y1.4
HSE_IN: C20.1, U1.5 (PH0), Y1.1
HSE_OUT: R8.1, U1.6 (PH1)
I2C1_SCL: J2.2, R11.1, U1.61 (PB8), U4.14 (SCL/SCLK), U6.6 (SCL)
I2C1_SDA: J2.1, R12.1, U1.62 (PB9), U4.13 (SDA/SDI/SDIO), U6.5 (SDA)
LB_PRE_DEB: J5.3, R29.2
LEFT_BUTTON: C7.1, R29.1, U1.59 (PB7)
NRST: C5.1, J5.7, J7.1, U1.7 (NRST)
unnamed: C19.1, R8.2, Y1.3
unnamed: D2.1 (K), R4.2
unnamed: IC1.10 (PROG), R1.1
unnamed: IC1.7 (STAT), R4.1
unnamed: Q1.4, R5.2
unnamed: R9.1, S1.2
unnamed: C22.1, U1.30 (VCAP_1)
unnamed: R2.2, R3.2, U2.3 (FB)
unnamed: L1.2, U2.1 (SW)
unnamed: R10.2, U4.12 (SDO/ADDR)
unnamed: R19.2, U4.7 (~CS)
PRESSURE_FRONT_OUT: J4.1, R25.1
PRESSURE_REAR_OUT: J4.2, R22.1
PRESSURE_SENSOR_FRONT: R24.1, R25.2, U1.15 (PA1)
PRESSURE_SENSOR_REAR: R21.1, R22.2, U1.16 (PA2)
PWR_SWITCH_IN: J5.4, Q1.5, Q1.6, Q1.7, Q1.8
PWR_SWITCH_OUT: BT2.-, C10.1, J5.6
RB_PRE_DEB: J5.5, R27.2
RCC_32_IN: C23.1, U1.3 (PC14), Y2.1
RCC_32_OUT: C24.1, U1.4 (PC15), Y2.2
RIGHT_BUTTON: C4.1, R27.1, U1.58 (PB6)
SDIO_CK: J3.5 (CLK), R14.1, U1.28 (PB2)
SDIO_CMD: J3.3 (CMD), R13.1, U1.54 (PD2)
SDIO_D0: J3.7 (DAT0), R17.1, U1.39 (PC8)
SDIO_D1: J3.8 (DAT1), R18.1, U1.40 (PC9)
SDIO_D2: J3.1 (DAT2), R16.1, U1.27 (PB1)
SDIO_D3: J3.2 (CD/DAT3), R15.1, U1.52 (PC11)
SD_detection: J3.CD1 (CARD_DETECTION), U1.41 (PA8)
SWDCLK: J7.6, U1.49 (PA14)
SWDIO: J7.5, U1.46 (PA13)
SWO: J7.4, U1.55 (PB3)
TRAVEL_SENOR_REAR: J4.5, U1.11 (PC3)
TRAVEL_SENSOR_FRONT: J4.6, U1.10 (PC2)
USB_OTG_FS_D+: U1.45 (PA12), U5.1 (I/O1)
USB_OTG_FS_D-: U1.44 (PA11), U5.3 (I/O2)
