porast1/suspension-telemetry/PCB_Design/Suspension_telemetry/travel_pressure_pcb/travel_pressure_pcb.kicad_pcb

## KiCad design PCB_Design/Suspension_telemetry/travel_pressure_pcb/travel_pressure_pcb.kicad_pcb (2023-11-22)

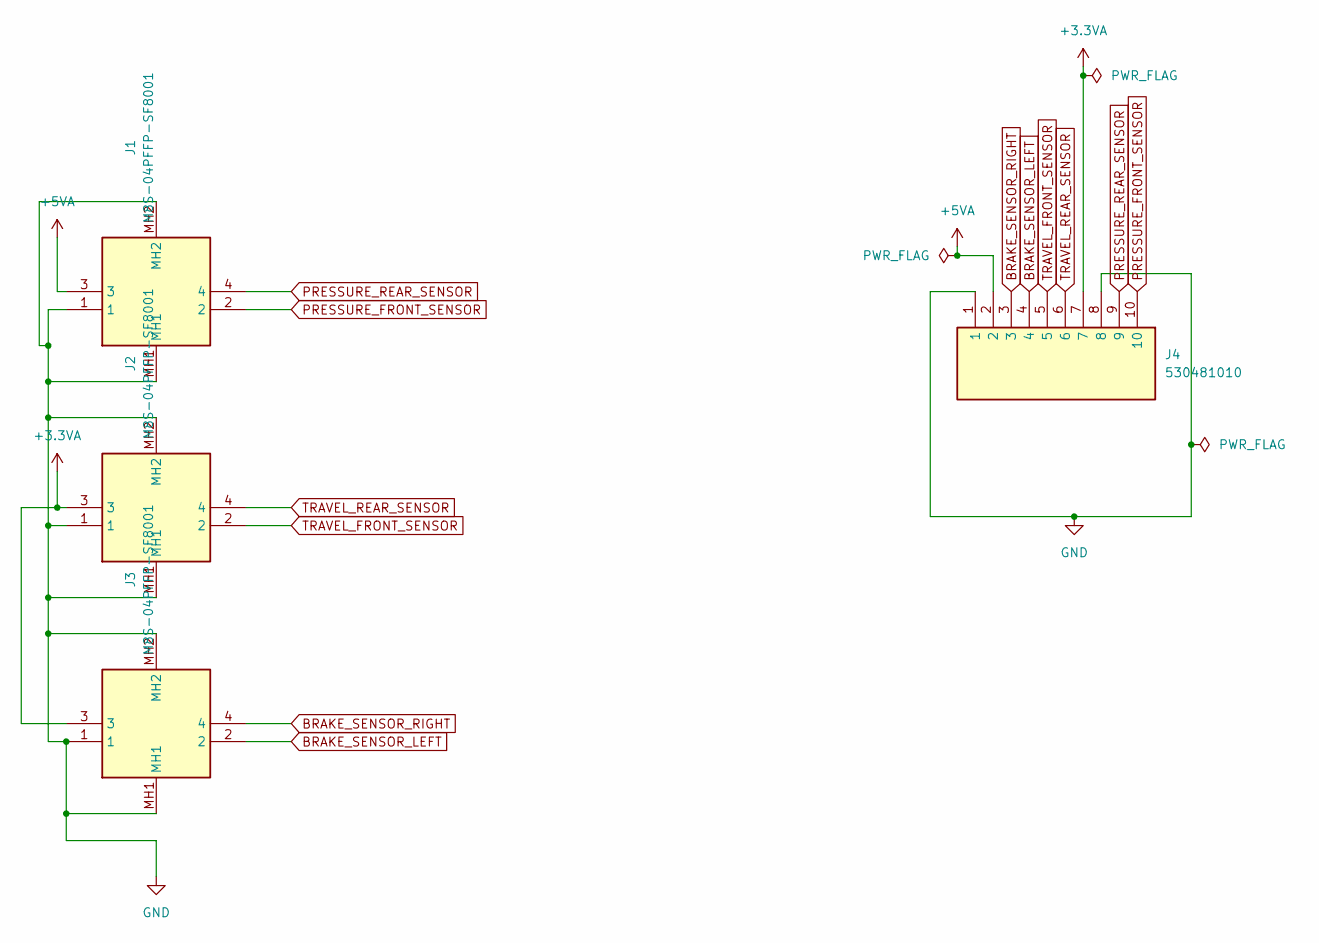
[picture p41: schematic travel_pressure_pcb.kicad_sch]

Parts:
J1, J2, J3: M8S-04PFFP-SF8001; M8S04PFFPSF8001; Manufacturer_Part_Number M8S-04PFFP-SF8001
J4: 530481010; Manufacturer_Part_Number 530481010

Connections:
+3.3VA: J2.3, J3.3, J4.7
+5VA: J1.3, J4.2
BRAKE_SENSOR_LEFT: J3.2, J4.4
BRAKE_SENSOR_RIGHT: J3.4, J4.3
GND: J1.1, J1.MH1, J1.MH2, J2.1, J2.MH1, J2.MH2, J3.1, J3.MH1, J3.MH2, J4.1, J4.8
PRESSURE_FRONT_SENSOR: J1.2, J4.10
PRESSURE_REAR_SENSOR: J1.4, J4.9
TRAVEL_FRONT_SENSOR: J2.2, J4.5
TRAVEL_REAR_SENSOR: J2.4, J4.6

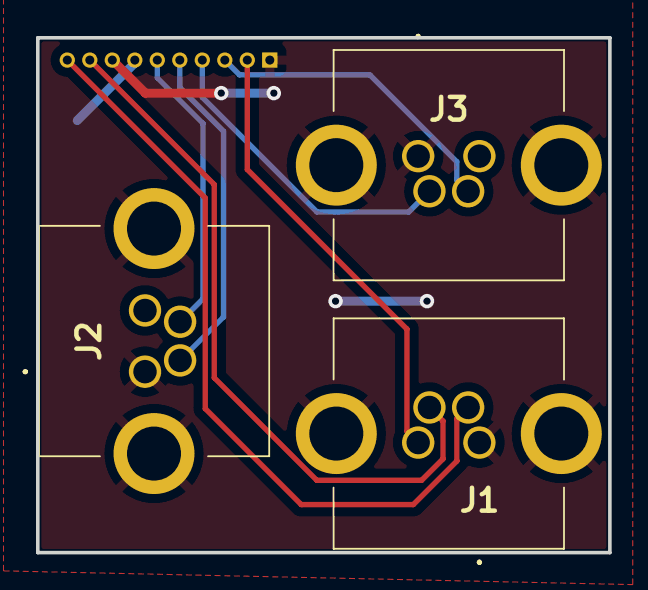
[picture p42: board travel_pressure_pcb.kicad_pcb from above]

Board: 2 copper layers, 31.8 x 28.6 mm, 4 parts (1 on the bottom side), 9 nets.
