porast1/suspension-telemetry/Embedded/DataModule.ioc

Mcu.UserName=STM32F446RETx
PA1.GPIO_Label=PRESSURE_SENSOR_FRONT
PA1.Signal=ADCx_IN1
PA11.Signal=USB_OTG_FS_DM
PA12.Signal=USB_OTG_FS_DP
PA13.GPIO_Label=TMS
PA13.Signal=SYS_JTMS-SWDIO
PA14.GPIO_Label=TCK
PA14.Signal=SYS_JTCK-SWCLK
PA15.GPIO_Label=CHARGE_DETECTION
PA15.Signal=GPIO_Input
PA2.GPIO_Label=PRESSURE_SENSOR_REAR
PA2.Signal=ADCx_IN2
PA4.GPIO_Label=BATTERY_LEVEL
PA4.Signal=ADCx_IN4
PA8.GPIO_Label=SD_detection
PA8.Signal=GPIO_Input
PB2.Signal=SDIO_CK
PB3.GPIO_Label=SWO
PB3.Signal=SYS_JTDO-SWO
PB6.GPIO_Label=RIGHT_BUTTON
PB6.Signal=GPIO_Input
PB7.GPIO_Label=LEFT_BUTTON
PB7.Signal=GPIO_Input
PB8.Signal=I2C1_SCL
PB9.Signal=I2C1_SDA
PC0.GPIO_Label=BRAKE_SENSOR_RIGHT
PC0.Signal=ADCx_IN10
PC1.GPIO_Label=BRAKE_SENSOR_LEFT
PC1.Signal=ADCx_IN11
PC14-OSC32_IN.Signal=RCC_OSC32_IN
PC15-OSC32_OUT.Signal=RCC_OSC32_OUT
PC2.GPIO_Label=TRAVEL_SENSOR_FRONT
PC2.Signal=ADCx_IN12
PC3.GPIO_Label=TRAVEL_SENSOR_REAR
PC3.Signal=ADCx_IN13
PC7.GPIO_Label=ACCELEROMETER_INT0
PC7.Signal=GPXTI7
PC8.Signal=SDIO_D0
PC9.Signal=SDIO_D1
PD2.Signal=SDIO_CMD
PH0-OSC_IN.Signal=RCC_OSC_IN
PH1-OSC_OUT.Signal=RCC_OSC_OUT
