porast1/suspension-telemetry/Embedded/Core/Inc/ADXL345.h

/****************************************************************************
 * Title                 :   Suspension Telemetry 
 * Filename              :   ADXL345.h
 * Author                :   patryk.grzywnowicz@gmail.com
 * Compiler              :   GCC
 * Target                :   data_acquisition_module
 * Notes                 :   None
 *****************************************************************************/

/** \file ADXL345.h
 *  \brief This module contains ...
 * 
 *  This is the header file for the definition for tasks that ...
 */
#ifndef INC_ADXL345_H_
#define INC_ADXL345_H_

/******************************************************************************
 * Includes
 *******************************************************************************/
#include "stdint.h"

/******************************************************************************
 * Preprocessor Constants
 *******************************************************************************/
/**
 * This constant is
 */

/******************************************************************************
 * Configuration Constants
 *******************************************************************************/

/******************************************************************************
 * Macros
 *******************************************************************************/

/******************************************************************************
 * Typedefs
 *******************************************************************************/

/******************************************************************************
 * Variables
 *******************************************************************************/

/******************************************************************************
 * Function Prototypes
 *******************************************************************************/
void adxl_write(uint8_t reg, uint8_t value);

void adxl_read_values(uint8_t reg);

void adxl_read_address(uint8_t reg);

void adxl_init(void);

#endif /* INC_ADXL345_H_ */

/*** End of File **************************************************************/
