porast1/suspension-telemetry/(commit log)

2023-07-15 data_acquisition_module: Init stm32 project
2023-07-16 data_acquisition_module: working two travel sensor DMA
2023-07-20 data_acquisition_module: working adc in 5ms period, add fat32 write/read
2023-07-26 button_driver: initial menu plus buttons
2023-07-27 button_driver: add separate folder per measurment
2023-07-31 pressure_sensor: add presure sensors plus calibration
2023-08-06 lcd_display: working lcd in i2c
2023-10-05 finished Schematic, PCB creation
    [112J-TDAR-R01.SchLib, 112J-TDAR-R01.stp, 112JTDARR01.PcbLib, 112jtdarr01.psm, 1825965-1.SchLib, 1825965-1.stp, 18259651.PcbLib, 18259651.psm]
2023-10-06 PCB: Finished
    [Power_Supply_3and5V.kicad_sch, STM32F446RET6_Base.kicad_sch, Suspension_telemetry.dsn, Suspension_telemetry.kicad_pcb, Suspension_telemetry.kicad_sch, USB_C.kicad_sch]
2023-10-16 GUI:all charts done
    [Marin.csv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]
2023-10-17 finished GUI
    [Marin.csv, output.csv]
2023-10-17 repair velocity chart
2023-11-04 before pcb v2
    [Suspension_telemetry-B_Cu.gbr, Suspension_telemetry-B_Mask.gbr, Suspension_telemetry-B_Paste.gbr, Suspension_telemetry-B_Silkscreen.gbr, Suspension_telemetry-Edge_Cuts.gbr, Suspension_telemetry-F_Cu.gbr, Suspension_telemetry-F_Mask.gbr, Suspension_telemetry-F_Paste.gbr]
2023-11-22 pcv v2 finished
    [112J-TDAR-R01.SchLib, 112J-TDAR-R01.stp, 112JTDARR01.PcbLib, 112jtdarr01.psm, 125SH-A-04-TS.SchLib, 125SH-A-04-TS.stp, 125SHA04TS.PcbLib, 125sha04ts.psm]
2023-12-13 resolved clock issues
    [12010973.stp, Mocowanie_obudowa_v2.stl, Obudowa_v2.stl, Pokrywa_v2.stl, ostatinie_mocowanie_v2.stl]
2023-12-28 adding swnsor mounts
    [Mocowanie Bateri.stl, Mocowanie Baterii.FCStd, Mocowanie wahacz tyl.stl, Power_Stabilizer_5V.kicad_sch, Power_Supply_3and5V.kicad_sch, STM32F446RET6_Base.kicad_sch, Suspension_telemetry.kicad_sch, mocowanie WAHACZ V4.stl]
2023-12-28 nothing special
    [mocowanie wahacz tyl.FCStd]
2024-03-27 add script
    [Enve M9 Carbon hanlebar DH.step, FirstPrint.3mf, FirstProject-Zawartość001Fillet002.stl, FirstProject.FCStd, Mocowanie Bateri.stl, Mocowanie Baterii.FCStd, Mocowanie wahacz tyl.stl, Mocowanie_obudowa_v2.stl]
2024-03-27 Updated .gitignore
    [Suspension_telemetry-B_Cu.gbr, Suspension_telemetry-B_Mask.gbr, Suspension_telemetry-B_Paste.gbr, Suspension_telemetry-B_Silkscreen.gbr, Suspension_telemetry-Edge_Cuts.gbr, Suspension_telemetry-F_Cu.gbr, Suspension_telemetry-F_Mask.gbr, Suspension_telemetry-F_Paste.gbr]
2024-03-28 add demo data
    [Demo_Data.CSV]
